Farving/Silent-Split-Supply/LTspice/Split Supply Single Buck Coupled Inductor v2.asc

C1: cap; 1µ
C2: cap; 1µ
C3: cap; 10µ
C4: cap; 100n
C5: cap; 4.7µ
C6: cap; 10µ
C7: cap; 1µ
D1: schottky; PMEG6010AED
L1: ind2; 2.2µ
L2: ind2; 2.2µ
R1: res; 18k
R2: res; 1Meg
R3: res; 56k
R4: res; {RL}
R5: res; {RL}
U1: LT8641
V1: voltage; 24V; Rser=0.01
Named nets: 0, Vpos, Vneg, Vgnd
.tran 300u uic
K1 L1 L2 0.98
.param RL=300
