Farving/Silent-Split-Supply/LTspice/Split Supply Single Buck Coupled Inductor.asc

C1: cap; 1µ
C2: cap; 1µ
C3: cap; {Cout}
C4: cap; 100n
C5: cap; {Cin}
C6: cap; {Cout}
C7: cap; 1µ
C8: cap; 22p
D1: schottky; B560C
L1: ind2; {L}
L2: ind2; {L}
R1: res; {RT}
R2: res; 1Meg
R3: res; 47k
R4: res; {RL}
R5: res; {RL}
U1: LT8641
V1: voltage; 48V; Rser=0.01
Named nets: 0, Vpos, Vneg
.tran 1m uic
K1 L1 L2 1
.param RL=18
.param Cout=10uF
.param Cin=4.7uF
.param L=2.2uH
.param RT=18k
