Farving/Silent-Split-Supply/KiCad/Noiseless Switching Supply.kicad_pcb

## KiCad design KiCad/Noiseless Switching Supply.kicad_pcb (2019-07-05)

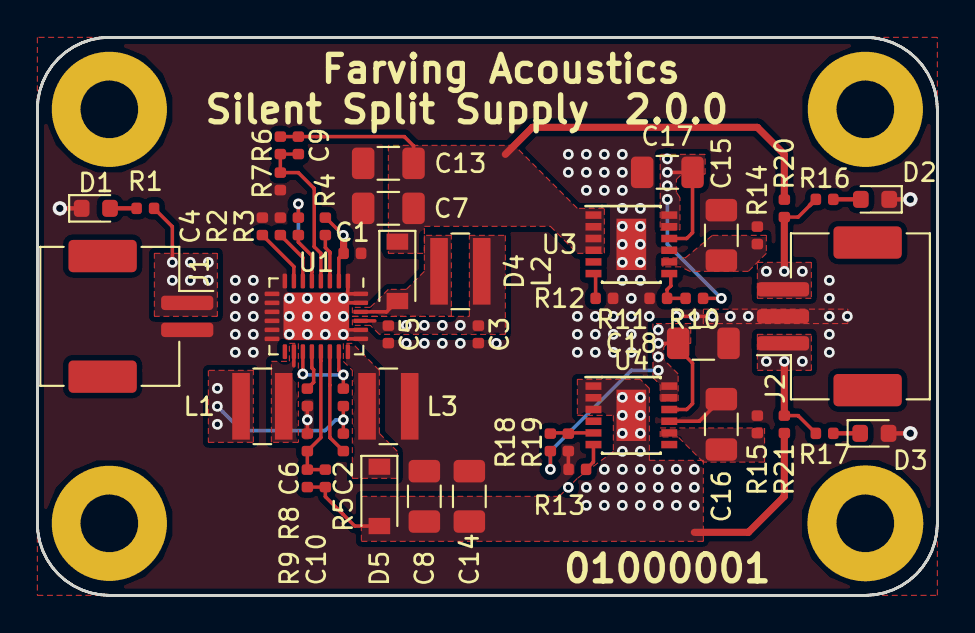
[picture p1: board Noiseless Switching Supply.kicad_pcb from above]

Board: 2 copper layers, 50.0 x 31.0 mm, 51 parts (0 on the bottom side), 27 nets.

Parts:
C1, C2: 1uF; C_0402_1005Metric
C3, C5: 2.2uF; C_0402_1005Metric
C4, C6: 100n; C_0402_1005Metric
C7, C8, C13, C14: 10u; C_1206_3216Metric
C9, C10: 10p; C_0402_1005Metric
C15, C16: 1u; C_1206_3216Metric
C17, C18: 10uF; C_1206_3216Metric
D1, D2, D3: LED_Small; LED_0603_1608Metric
D4, D5: D_Small; D_SOD-123
J1: JST S2B-ZR-SMA4-TF; JST_ZE_SM02B-ZESS-TBT_1x02-1MP_P1.50mm_Horizontal
J2: JST S3B-ZR-SMA4-TF; JST_ZE_SM03B-ZESS-TBT_1x03-1MP_P1.50mm_Horizontal
L1, L2, L3: 10u; L_Wuerth_MAPI-4030
PCB1: Board_Module; PCB_Board_50x31
R1, R16, R17: 1k; R_0402_1005Metric
R2: 82k; R_0402_1005Metric
R3, R4, R5: 100k; R_0402_1005Metric
R6, R9: 390k; R_0402_1005Metric
R7, R8, R11, R18: 18k; R_0402_1005Metric
R10, R19: 750k; R_0402_1005Metric
R12, R13, R20, R21: 0R; R_0402_1005Metric
R14, R15: 150k; R_0402_1005Metric
U1: LT8471; QFN-28-1EP_4x5mm_P0.5mm_EP2.65x3.65mm
U3: LT3045; MSOP-12-1EP_3x4mm_P0.65mm_EP1.65x2.85mm
U4: LT3094; MSOP-12-1EP_3x4mm_P0.65mm_EP1.65x2.85mm

Connections:
+15V: C17.1, J2.3, R10.1, R16.1, R20.1, U3.10, U3.11, U3.12
-15V: C18.2, J2.1, R17.2, R19.2, R21.1, U4.10, U4.11, U4.12
/VIN: C1.1, C2.1, C3.1, C5.1, J1.1, L1.1, L2.1, R1.1, R3.2, R4.2, R5.2, U1.2, U1.25
GND: C1.2, C3.2, C4.2, C5.2, C6.2, C7.2, C8.1, C13.2, C14.1, C15.2, C16.1, C17.2, C18.1, D1.1, D2.1, D3.2, J1.2, J2.2, L3.2, R2.2, R7.2, R8.1, R11.2, R12.2, R13.1, R14.2, R15.1, R18.1, U1.1, U1.8, U1.9, U1.10, U1.11, U1.12, U1.13, U1.14, U1.23, U1.24, U1.27, U1.28, U1.29, U3.9, U3.13, U4.9
unnamed: C2.2, U1.17, U1.21
unnamed: C4.1, U1.7
unnamed: C6.1, U1.18
unnamed: C9.2, R6.2, R7.1, U1.4
unnamed: C10.1, R8.2, R9.1, U1.19
unnamed: C15.1, R14.1, U3.8
unnamed: C16.2, R15.2, U4.8
unnamed: D1.2, R1.2
unnamed: D2.2, R16.2
unnamed: D3.1, R17.1
unnamed: D4.2, L2.2, U1.26
unnamed: D5.1, L3.1, U1.22
unnamed: L1.2, U1.16
unnamed: R2.1, U1.6
unnamed: R3.1, U1.5
unnamed: R4.1, U1.3
unnamed: R5.1, U1.20
unnamed: R10.2, R11.1, U3.7
unnamed: R12.1, U3.6
unnamed: R13.2, U4.6
unnamed: R18.2, R19.1, U4.5
VCC: C7.1, C9.1, C13.1, D4.1, R6.1, R20.2, U3.1, U3.2, U3.3, U3.4
VEE: C8.2, C10.2, C14.2, D5.2, R9.2, R21.2, U4.1, U4.2, U4.3, U4.13
