Farving/Silent-Split-Supply/(threads)

Thread 1 (2019-07-05):

Simplify BOM

Farving, 2019-07-05:
Change C3 +  C5 to 2x 1u 25V 0402
Change C15 + C16 to 1u 25V 0402

Farving, 2019-07-19:
As CC0805KKX5R8BB106 is cheaper than its 1206 counterpart, change C7, C8, C13, C14, C17 and C18 to 0805

Thread 3 (2019-07-10):

Optimize efficiency

Farving, 2019-07-10:
Change U3 to LT3045-1 and use VIOC feature to set SMPS output to 1V above LDO output

Similar use VIOC feature on U4 to set SMPS output to 1V below LDO output (Negative rail)

This is to increase efficiency while retaining maximum regulation performance. Additionally a single resistor sets output voltage.

Thread 5 (2019-07-11):

Change connector to JST-PH series

Farving, 2019-07-11:
Switching all connectors forward going to JST-PH THT series.

Preferably angled footprint (THT can be mounted in these, but around could cause issues)
