Farving/Silent-Split-Supply/(commit log)

2018-11-13 Alpha release
    [Noiseless Switching Supply.kicad_pcb, Noiseless Switching Supply.sch]
2019-01-27 Add simulation for single buck solution
2019-02-01 Add Comments for rev 2
    [Noiseless Switching Supply.kicad_pcb, Noiseless Switching Supply.sch]
2019-05-07 2.0.0 Release
    [Noiseless Switching Supply-B.Cu.gbr, Noiseless Switching Supply-B.Mask.gbr, Noiseless Switching Supply-B.Paste.gbr, Noiseless Switching Supply-B.SilkS.gbr, Noiseless Switching Supply-Edge.Cuts.gbr, Noiseless Switching Supply-F.Cu.gbr, Noiseless Switching Supply-F.Mask.gbr, Noiseless Switching Supply-F.Paste.gbr]
2019-06-11 Cleanup production and temporary files
    [Noiseless Switching Supply-B.Cu.gbr, Noiseless Switching Supply-B.Mask.gbr, Noiseless Switching Supply-B.Paste.gbr, Noiseless Switching Supply-B.SilkS.gbr, Noiseless Switching Supply-Edge.Cuts.gbr, Noiseless Switching Supply-F.Cu.gbr, Noiseless Switching Supply-F.Mask.gbr, Noiseless Switching Supply-F.Paste.gbr]
2019-06-11 Update schematic
    [Noiseless Switching Supply.sch]
2019-06-11 Folder Restructuring
    [Noiseless Switching Supply.kicad_pcb, Noiseless Switching Supply.sch]
2019-07-05 Release 2.0.0
    [Noiseless Switching Supply.kicad_pcb, Noiseless Switching Supply.sch]
2019-07-05 Revert "Release 2.0.0"
    This reverts commit 205842f1cedd4a8ccdb19813492daaf6a9c54026.
    [Noiseless Switching Supply.kicad_pcb, Noiseless Switching Supply.sch]
